gvsolgryn/Sixtar-Switch/Sixtar-Switch_PCB/image/layout.png

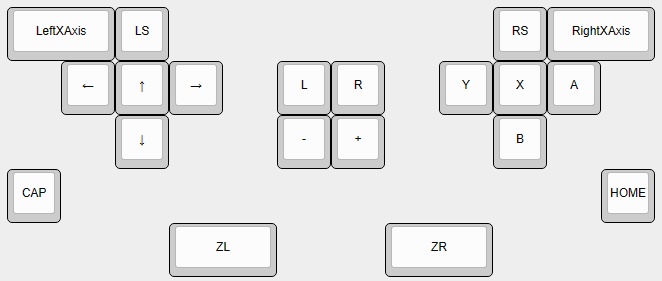
Sixtar-Switch_PCB/image/layout.png
