gvsolgryn/Sixtar-Switch/Sixtar-Switch_PCB/image/Sixtar-Switch.png

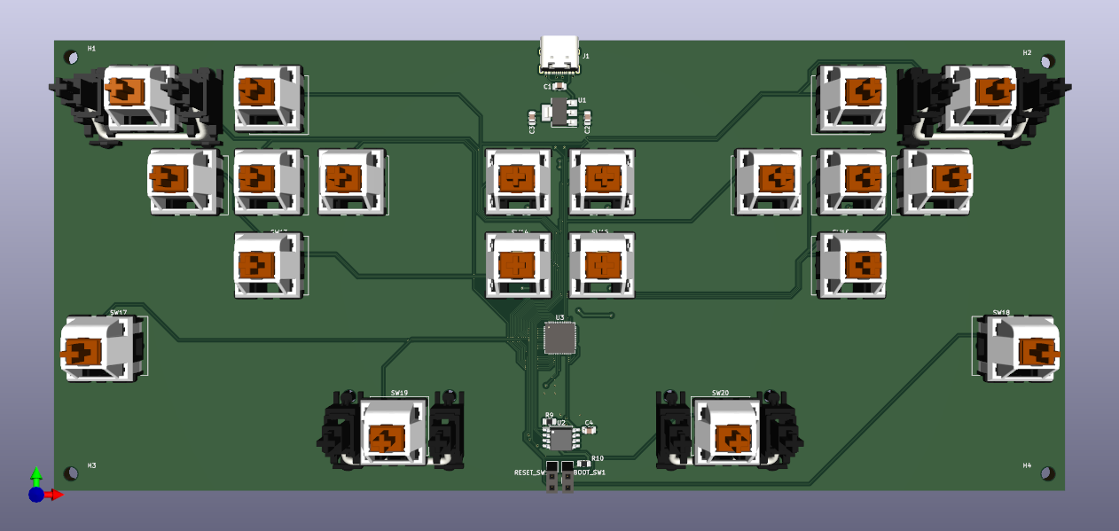
Sixtar-Switch_PCB/image/Sixtar-Switch.png
