gvsolgryn/Sixtar-Switch/Sixtar-Switch_PCB/image/Sixtar-Switch_2d.png

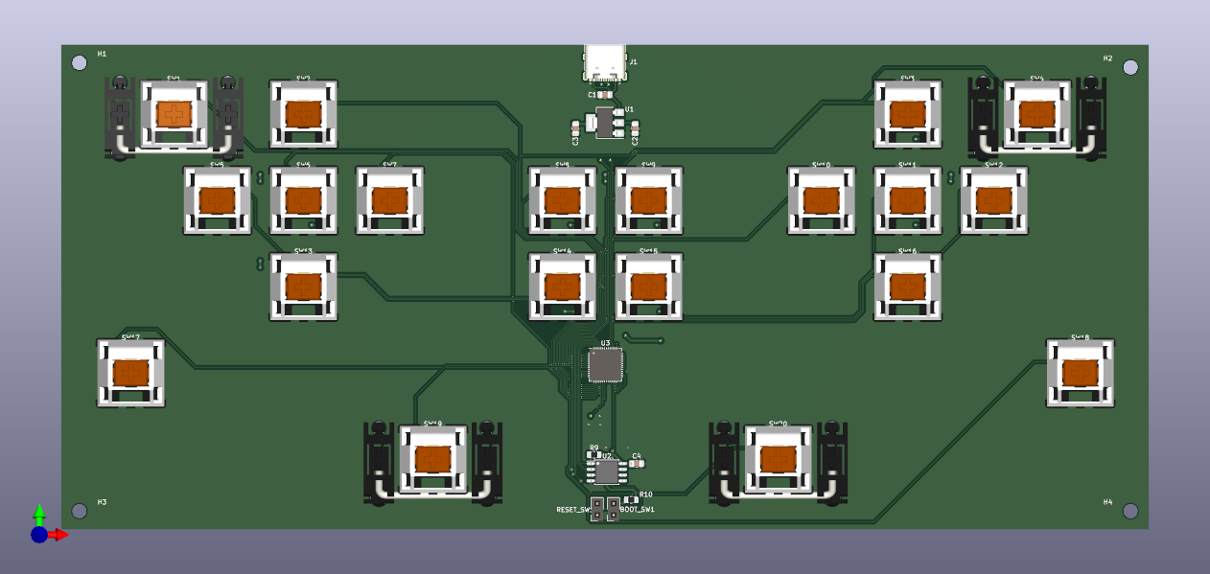
Sixtar-Switch_PCB/image/Sixtar-Switch_2d.png
