gvsolgryn/Sixtar-Switch/Sixtar-Switch_PCB/3dmodel/AMS117.stl

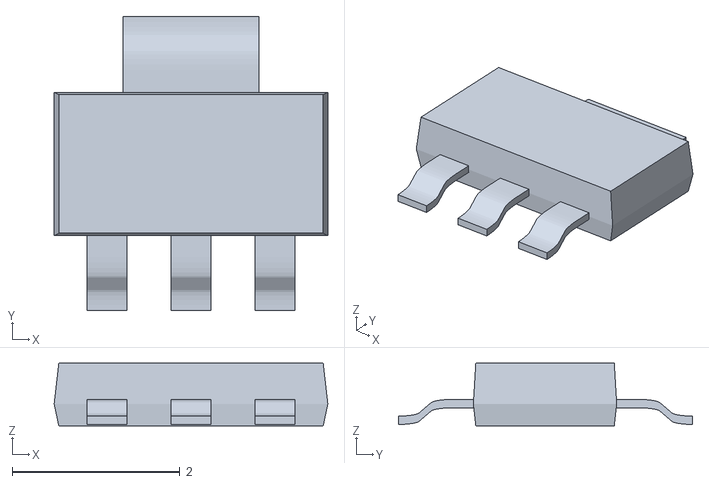
[picture p4: CAD file, 2023-10-04]
Sixtar-Switch_PCB/3dmodel/AMS117.stl
3.26 x 3.50 x 0.75
