gvsolgryn/Sixtar-Switch/Sixtar-Switch_PCB/gerber/Sixtar-Switch-PTH-drl_map.dxf

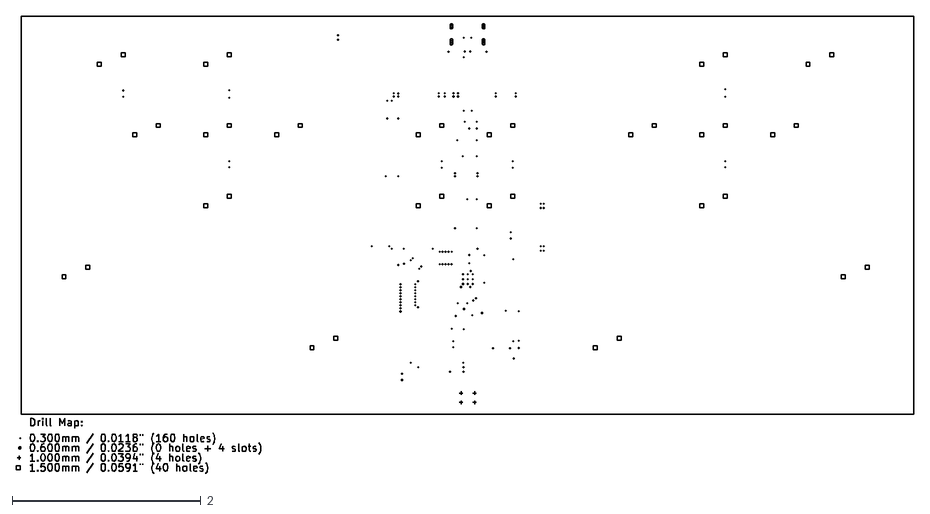
[picture p6: CAD file, 2023-10-05]
Sixtar-Switch_PCB/gerber/Sixtar-Switch-PTH-drl_map.dxf
9.50 x 4.84
