gvsolgryn/Sixtar-Switch/Sixtar-Switch_PCB/3dmodel/mx_switch/SW_Hotswap_Kailh_Choc_V1.stp

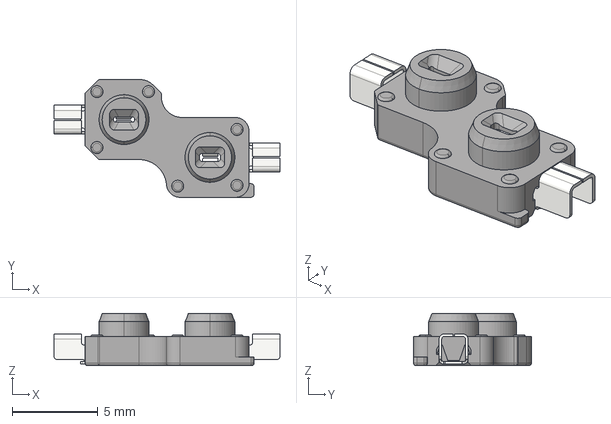
[picture p7: CAD file, 2023-10-04]
Sixtar-Switch_PCB/3dmodel/mx_switch/SW_Hotswap_Kailh_Choc_V1.stp
13.2 x 6.85 x 3.05 mm
