gvsolgryn/Sixtar-Switch/Sixtar-Switch_PCB/3dmodel/W25Q128JVSIQ.STEP

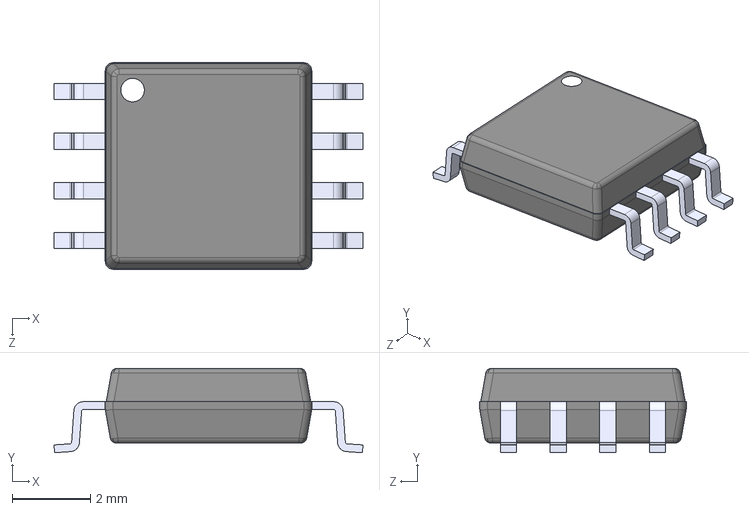
[picture p8: CAD file, 2023-10-04]
Sixtar-Switch_PCB/3dmodel/W25Q128JVSIQ.STEP
7.90 x 2.16 x 5.28 mm
