gvsolgryn/Sixtar-Switch/Sixtar-Switch_PCB/gerber/Sixtar-Switch-NPTH-drl_map.dxf

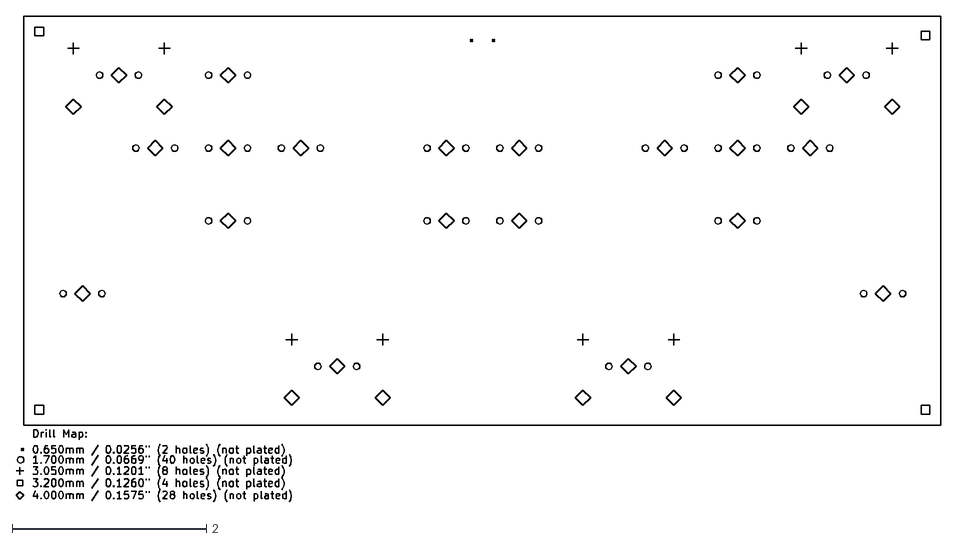
[picture p9: CAD file, 2023-10-04]
Sixtar-Switch_PCB/gerber/Sixtar-Switch-NPTH-drl_map.dxf
9.53 x 5.00
