gvsolgryn/Sixtar-Switch/Sixtar-Switch_PCB/3dmodel/mx_switch/Stabilizer_Cherry_MX_6.25u.stp

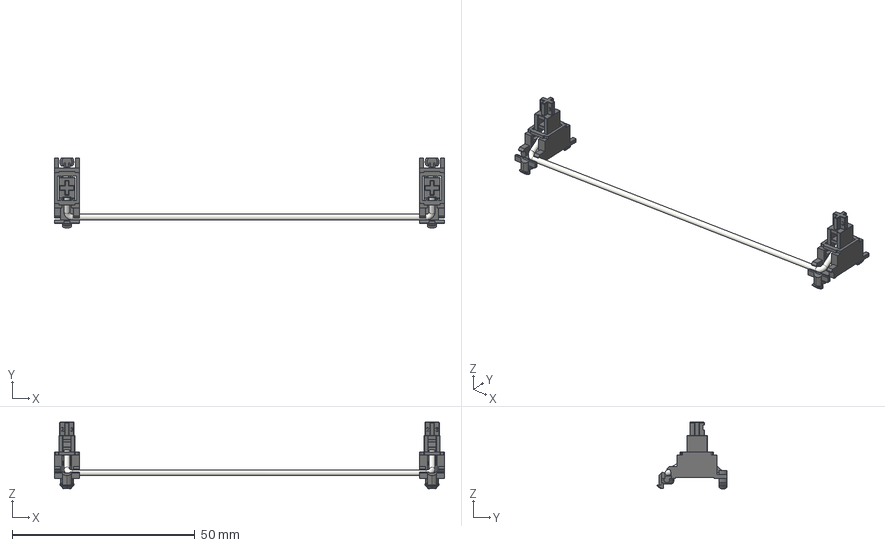
[picture p10: CAD file, 2023-10-04]
Sixtar-Switch_PCB/3dmodel/mx_switch/Stabilizer_Cherry_MX_6.25u.stp
106.8 x 19.2 x 18.3 mm
