gvsolgryn/Sixtar-Switch/Sixtar-Switch_PCB/3dmodel/u262-16xn-4bvc11.stl

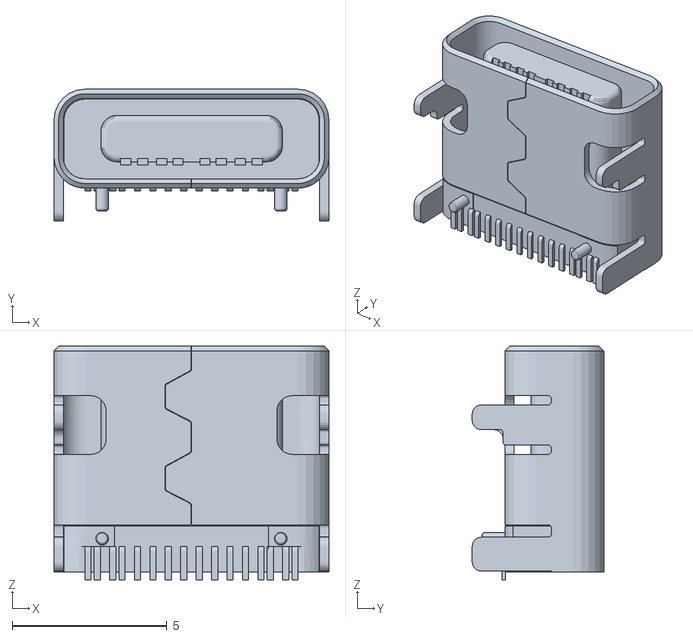
[picture p11: CAD file, 2023-10-04]
Sixtar-Switch_PCB/3dmodel/u262-16xn-4bvc11.stl
8.90 x 4.26 x 7.56
