gvsolgryn/Sixtar-Switch/Sixtar-Switch_PCB/3dmodel/mx_switch/SW_Hotswap_Kailh_MX.stp

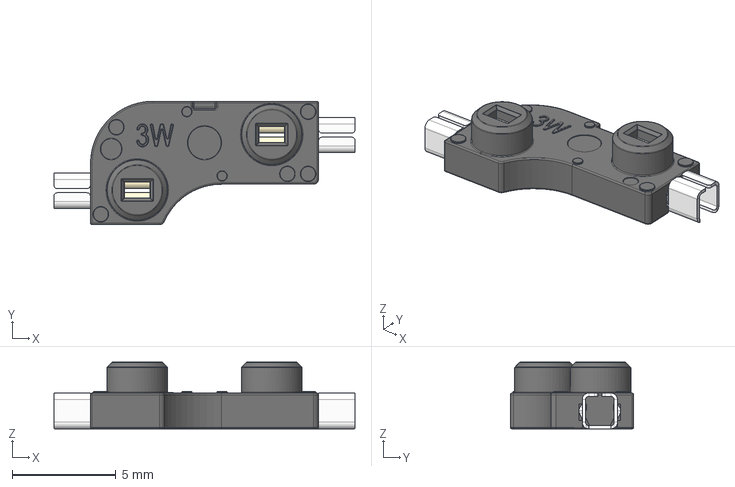
[picture p12: CAD file, 2023-10-04]
Sixtar-Switch_PCB/3dmodel/mx_switch/SW_Hotswap_Kailh_MX.stp
14.5 x 5.95 x 3.22 mm
