gvsolgryn/Sixtar-Switch/Sixtar-Switch_PCB/3dmodel/mx_switch/Stabilizer_Cherry_MX_8.00u.stp

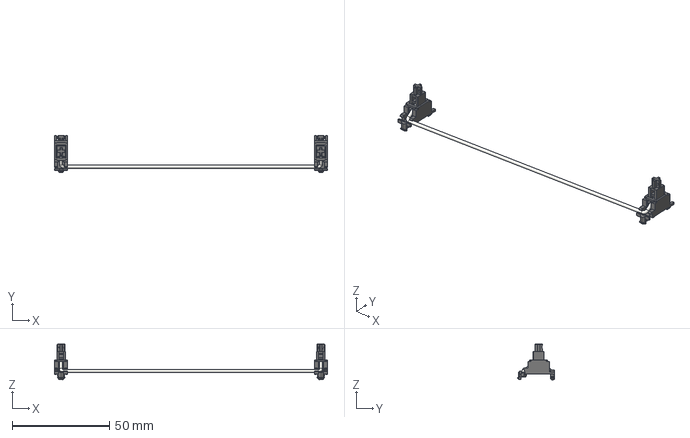
[picture p13: CAD file, 2023-10-04]
Sixtar-Switch_PCB/3dmodel/mx_switch/Stabilizer_Cherry_MX_8.00u.stp
140.1 x 19.2 x 18.3 mm
