gvsolgryn/Sixtar-Switch/Sixtar-Switch_PCB/3dmodel/mx_switch/SW_Cherry_MX_Plate.stp

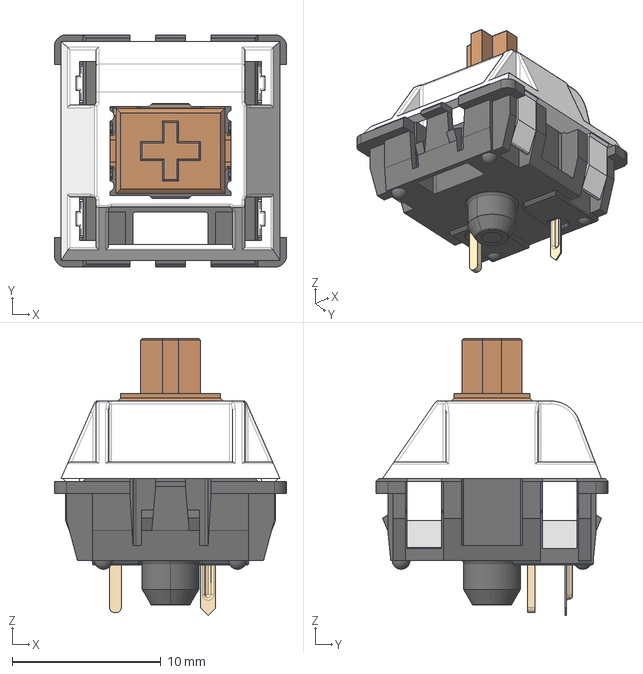
[picture p14: CAD file, 2023-10-04]
Sixtar-Switch_PCB/3dmodel/mx_switch/SW_Cherry_MX_Plate.stp
15.6 x 15.6 x 18.6 mm
