gvsolgryn/Sixtar-Switch/Sixtar-Switch_PCB/3dmodel/mx_switch/SW_Kailh_Choc_V1.stp

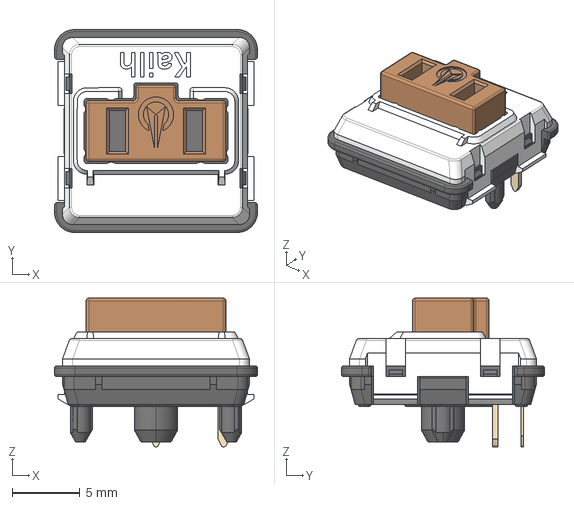
[picture p16: CAD file, 2023-10-04]
Sixtar-Switch_PCB/3dmodel/mx_switch/SW_Kailh_Choc_V1.stp
15.0 x 15.0 x 11.0 mm
