gvsolgryn/Sixtar-Switch/Sixtar-Switch_PCB/Sixtar-Switch.kicad_pcb

## KiCad design Sixtar-Switch_PCB/Sixtar-Switch.kicad_pcb (2023-10-05)

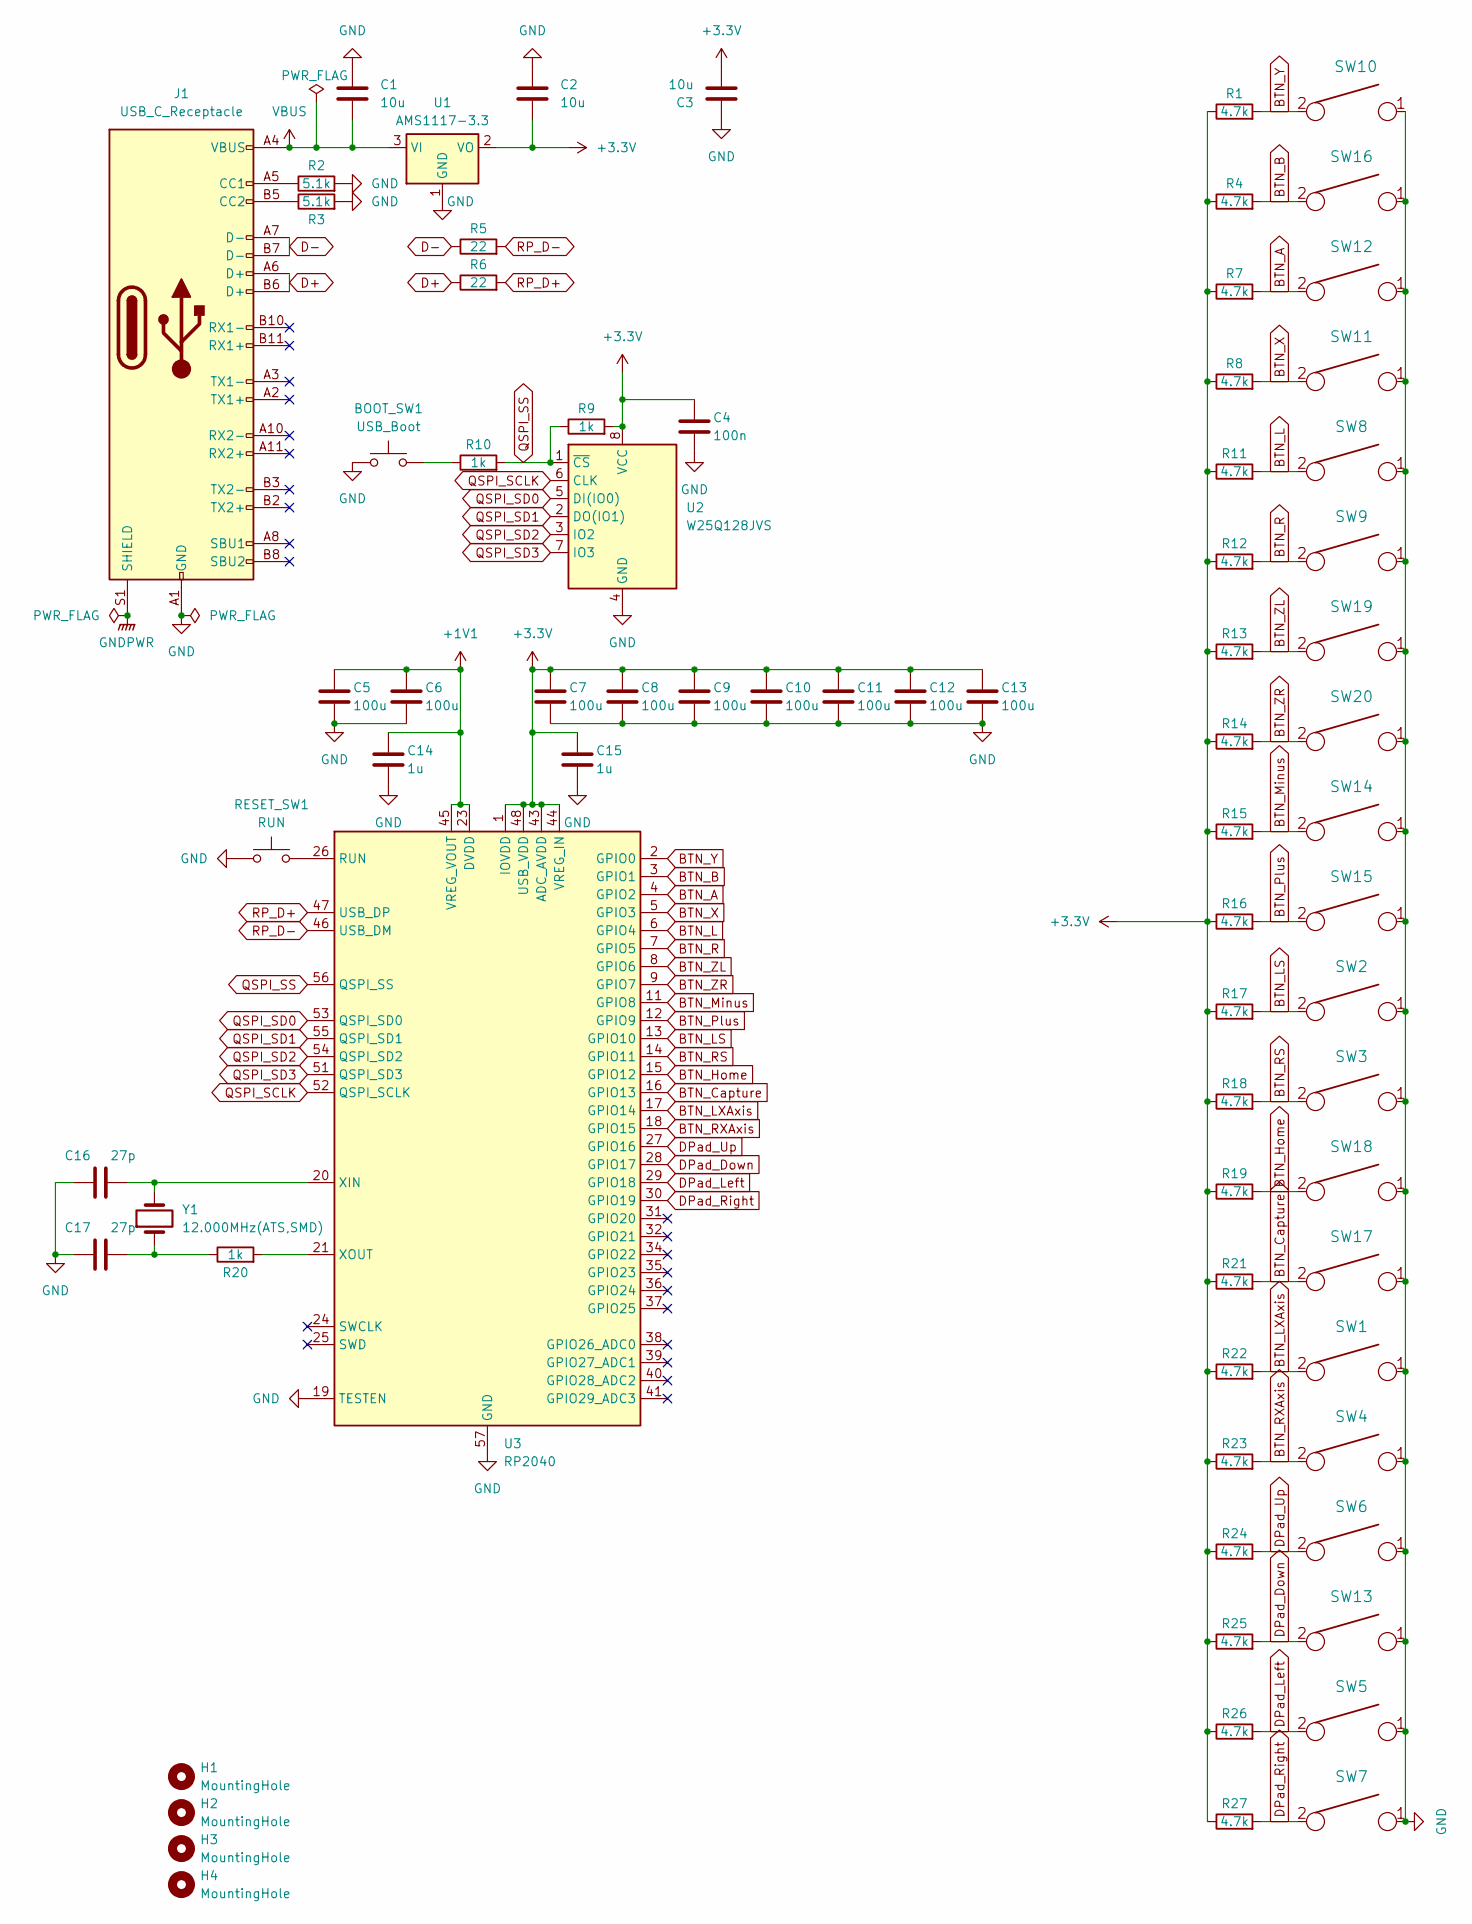
[picture p20: schematic Sixtar-Switch.kicad_sch]

Parts:
BOOT_SW1: USB_Boot; PinSocket_1x02_P2.54mm_Vertical
C1, C2, C3: 10u; C_0805_2012Metric_Pad1.18x1.45mm_HandSolder
C4: 100n; C_0805_2012Metric_Pad1.18x1.45mm_HandSolder
C5, C6, C7, C8, C9, C10, C11, C12, C13: 100u; C_0805_2012Metric_Pad1.18x1.45mm_HandSolder
C14, C15: 1u; C_0805_2012Metric_Pad1.18x1.45mm_HandSolder
C16, C17: 27p; C_0805_2012Metric_Pad1.18x1.45mm_HandSolder
H1, H2, H3, H4: MountingHole; MountingHole_3.2mm_M3
J1: USB_C_Receptacle; USB_C_Receptacle_XKB_U262-16XN-4BVC11
R1, R4, R7, R8, R11, R12, R13, R14, R15, R16, R17, R18, R19, R21, R22, R23, R24, R25, R26, R27: 4.7k; R_0805_2012Metric_Pad1.20x1.40mm_HandSolder
R2, R3: 5.1k; R_0805_2012Metric_Pad1.20x1.40mm_HandSolder
R5, R6: 22; R_0805_2012Metric_Pad1.20x1.40mm_HandSolder
R9, R10, R20: 1k; R_0805_2012Metric_Pad1.20x1.40mm_HandSolder
RESET_SW1: RUN; PinSocket_1x02_P2.54mm_Vertical
SW1, SW4, SW19, SW20: KEYSW; SW_Cherry_MX_2.00u_PCB
SW2, SW3, SW5, SW6, SW7, SW8, SW9, SW10, SW11, SW12, SW13, SW14, SW15, SW16, SW17, SW18: KEYSW; SW_Cherry_MX_1.00u_PCB
U1: AMS1117-3.3; SOT-223-3_TabPin2
U2: W25Q128JVS; SOIC-8_5.23x5.23mm_P1.27mm
U3: RP2040; QFN-56-1EP_7x7mm_P0.4mm_EP3.2x3.2mm
Y1: 12.000MHz(ATS,SMD); Crystal_SMD_5032-2Pin_5.0x3.2mm

Connections:
+1V1: C5.1, C6.1, C14.1, U3.23 (DVDD), U3.45 (VREG_VOUT), U3.50 (DVDD)
+3.3V: C2.2, C3.2, C4.1, C7.1, C8.1, C9.1, C10.1, C11.1, C12.1, C13.1, C15.1, R1.1, R4.1, R7.1, R8.1, R9.2, R11.1, R12.1, R13.1, R14.1, R15.1, R16.1, R17.1, R18.1, R19.1, R21.1, R22.1, R23.1, R24.1, R25.1, R26.1, R27.1, U1.2 (VO), U2.8 (VCC), U3.1 (IOVDD), U3.10 (IOVDD), U3.22 (IOVDD), U3.33 (IOVDD), U3.42 (IOVDD), U3.43 (ADC_AVDD), U3.44 (VREG_IN), U3.48 (USB_VDD), U3.49 (IOVDD)
BTN_A: R7.2, SW12.2, U3.4 (GPIO2)
BTN_B: R4.2, SW16.2, U3.3 (GPIO1)
BTN_Capture: R21.2, SW17.2, U3.16 (GPIO13)
BTN_Home: R19.2, SW18.2, U3.15 (GPIO12)
BTN_L: R11.2, SW8.2, U3.6 (GPIO4)
BTN_LS: R17.2, SW2.2, U3.13 (GPIO10)
BTN_LXAxis: R22.2, SW1.2, U3.17 (GPIO14)
BTN_Minus: R15.2, SW14.2, U3.11 (GPIO8)
BTN_Plus: R16.2, SW15.2, U3.12 (GPIO9)
BTN_R: R12.2, SW9.2, U3.7 (GPIO5)
BTN_RS: R18.2, SW3.2, U3.14 (GPIO11)
BTN_RXAxis: R23.2, SW4.2, U3.18 (GPIO15)
BTN_X: R8.2, SW11.2, U3.5 (GPIO3)
BTN_Y: R1.2, SW10.2, U3.2 (GPIO0)
BTN_ZL: R13.2, SW19.2, U3.8 (GPIO6)
BTN_ZR: R14.2, SW20.2, U3.9 (GPIO7)
D+: J1.A6 (D+), J1.B6 (D+), R6.1
D-: J1.A7 (D-), J1.B7 (D-), R5.1
DPad_Down: R25.2, SW13.2, U3.28 (GPIO17)
DPad_Left: R26.2, SW5.2, U3.29 (GPIO18)
DPad_Right: R27.2, SW7.2, U3.30 (GPIO19)
DPad_Up: R24.2, SW6.2, U3.27 (GPIO16)
GND: BOOT_SW1.1, C1.1, C2.1, C3.1, C4.2, C5.2, C6.2, C7.2, C8.2, C9.2, C10.2, C11.2, C12.2, C13.2, C14.2, C15.2, C16.1, C17.1, J1.A1 (GND), J1.A12 (GND), J1.B1 (GND), J1.B12 (GND), R2.2, R3.2, RESET_SW1.1, SW1.1, SW2.1, SW3.1, SW4.1, SW5.1, SW6.1, SW7.1, SW8.1, SW9.1, SW10.1, SW11.1, SW12.1, SW13.1, SW14.1, SW15.1, SW16.1, SW17.1, SW18.1, SW19.1, SW20.1, U1.1 (GND), U2.4 (GND), U3.19 (TESTEN), U3.57 (GND)
GNDPWR: J1.S1 (SHIELD)
unnamed: BOOT_SW1.2, R10.1
unnamed: C17.2, R20.1, Y1.1
unnamed: J1.A5 (CC1), R2.1
unnamed: J1.B5 (CC2), R3.1
unnamed: RESET_SW1.2, U3.26 (RUN)
unnamed: C16.2, U3.20 (XIN), Y1.2
unnamed: R20.2, U3.21 (XOUT)
QSPI_SCLK: U2.6 (CLK), U3.52 (QSPI_SCLK)
QSPI_SD0: U2.5 (DI(IO0)), U3.53 (QSPI_SD0)
QSPI_SD1: U2.2 (DO(IO1)), U3.55 (QSPI_SD1)
QSPI_SD2: U2.3 (IO2), U3.54 (QSPI_SD2)
QSPI_SD3: U2.7 (IO3), U3.51 (QSPI_SD3)
QSPI_SS: R9.1, R10.2, U2.1 (~CS), U3.56 (QSPI_SS)
RP_D+: R6.2, U3.47 (USB_DP)
RP_D-: R5.2, U3.46 (USB_DM)
VBUS: C1.2, J1.A4 (VBUS), J1.A9 (VBUS), J1.B4 (VBUS), J1.B9 (VBUS), U1.3 (VI)

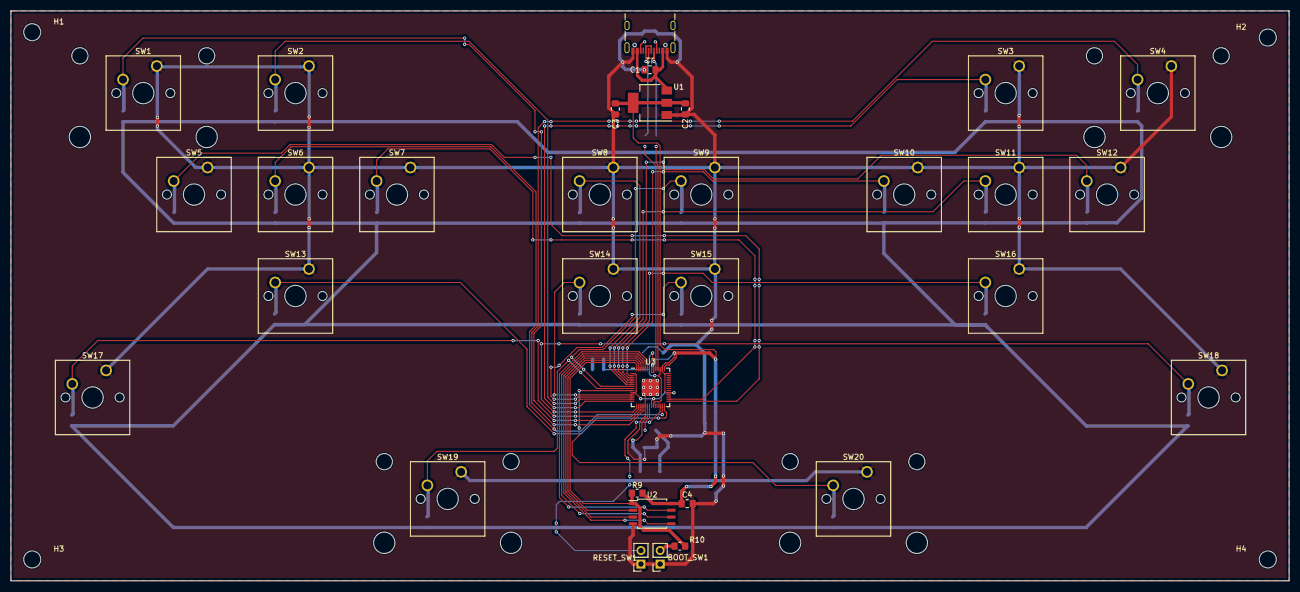
[picture p21: board Sixtar-Switch.kicad_pcb from above]

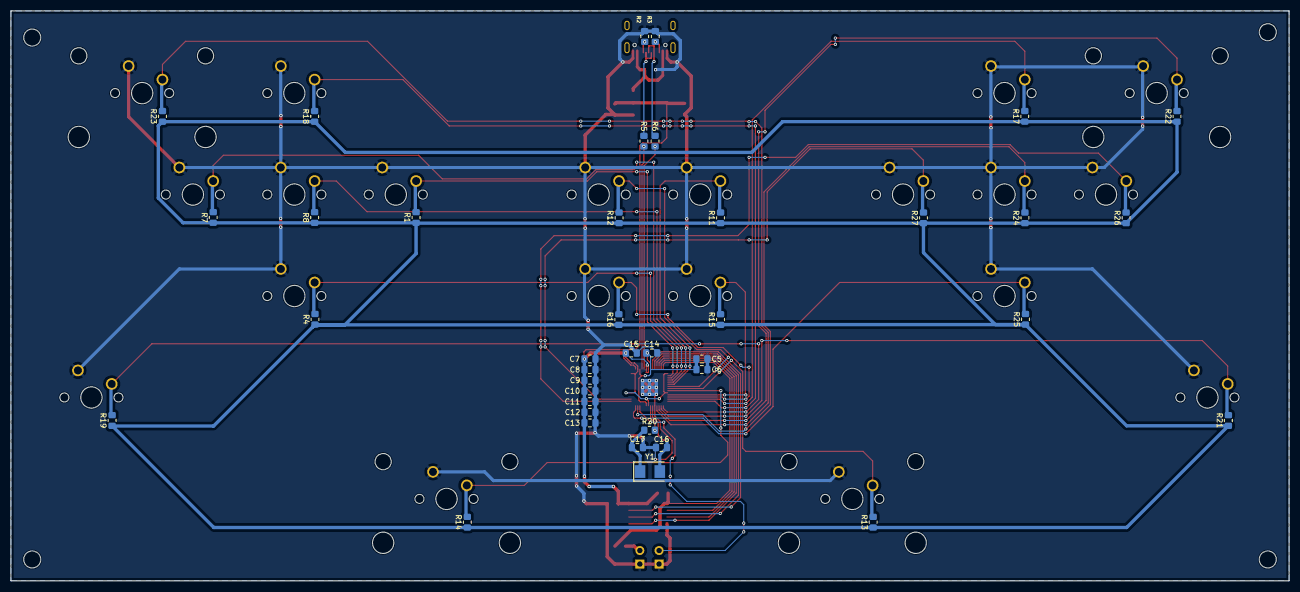
[picture p22: board Sixtar-Switch.kicad_pcb from below]

Board: 2 copper layers, 240.0 x 107.0 mm, 75 parts (39 on the bottom side), 41 nets.
