gvsolgryn/Sixtar-Switch/(commit log)

2023-04-03 KiCad Project init
    [Sixtar-Switch.kicad_pcb, Sixtar-Switch.kicad_sch]
2023-04-03 Add new Directory for PCB
    [Sixtar-Switch.kicad_pcb, Sixtar-Switch.kicad_sch]
2023-04-03 Init Arduino Workspace
2023-05-09 RPi-Pico SDK Submodule 설정
2023-05-10 gitsubmodule 제거
2023-05-10 펌웨어 코드 위치 변경
2023-05-10 includepath 변경(진행중)
2023-05-10 SwitchControlLibrary 추가(포팅필요)
2023-05-10 폴더 이름 변경 및 폴더 위치 변경
2023-05-10 tiniusb 지원을 위해 코드 추가
2023-05-10 .gitignore 추가
2023-05-10 vscode setting 수정
2023-05-10 tinyusb 빌드를 위해 수정
2023-05-10 pico-example 코드로 변경
2023-05-10 GamePad 기초 테스트 코드로 수정
2023-05-10 VID PID 수정 및 GamePad 로만 인식하도록 수정
2023-05-11 .vscode 폴더 업로드 안하도록 .gitignore 수정
2023-05-11 gitignore 수정 및 git 캐시삭제
2023-05-12 GamePad HID 전송 안되던 오류 수정
2023-05-12 코드 수정중
2023-05-15 코드 위치 변경 (src -> src/include)
2023-05-15 코드 위치 변경에 따른 CMakeLists 변경
2023-05-15 포팅 or 참조용 코드 위치 변경
2023-05-15 불필요한 코드 삭제
2023-05-15 switchControllLibrary 참조하여 헤더 추가
2023-05-15 테스트용 코드 수정 - boot 버튼 누를 시 Hat UP 하도록 수정
2023-05-16 rp2040 HID Gamepad 기초 코드 작성
2023-05-16 들여쓰기 4 -> 공백 4 로 변경
2023-05-16 nintendo switch joystick report (테스트 필요)
2023-05-16 버그 수정중 - HID 인식 안됨 - 포팅을 다시 진행해야함
2023-05-18 닌텐도 스위치용 HID 디스크립터 변경
2023-05-18 스위치 작동 확인 하지만 버그 발견 - 엔디안 오류가 있는 것 같음
2023-09-18 gitignore 수정
2023-09-18 소스코드 테스트중...
2023-09-19 디렉터리 정리
2023-09-19 Raspberry Pi Pico C/C++ SDK 이용 스위치 컨트롤러 코드 수정 완료 - GPIO0 ~ GPIO13에 버튼값들 할당 완료 - HAT 및 다른 기능들 추가 해야함
    [main.cpp, main.h]
2023-09-19 닌텐도 스위치의 모든 버튼 및 axis 작동 확인 - GPIO0 ~ 13 = 스위치 버튼 Y, B, A, X, L트리거, R트리거, ZL트리거, ZR트리거, 마이너스, 플러스, L스틱, R스틱, 홈, 캡쳐 - GPIO14 = L스틱 왼쪽방향으로 틀기 - GPIO15 = R스틱 오른쪽방향으로 틀기
    [Sixtar-Switch.kicad_sch]
2023-09-19 닌텐도 스위치의 dPad 버튼 작동 확인 - GPIO15 ~ 18 = up, down, left, right 로 매핑
2023-09-19 pin 중복 할당 수정
    [main.h]
2023-09-19 kicad 회로 수정
    [Sixtar-Switch.kicad_sch]
2023-09-25 KiCAD 회로 수정 및 PCB 제작중
    [Sixtar-Switch.kicad_pcb, Sixtar-Switch.kicad_sch]
2023-09-25 키 배치 수정
    [Sixtar-Switch.kicad_pcb, Sixtar-Switch.kicad_sch]
2023-09-25 저항 배치중
    [Sixtar-Switch.kicad_pcb]
2023-09-26 저항 배치 및 배선 그리는중
    [Sixtar-Switch.kicad_pcb]
2023-10-04 PCB빌드 완료. 테스트 필요
    [Sixtar-Switch-B_Adhesive.gbr, Sixtar-Switch-B_Courtyard.gbr, Sixtar-Switch-B_Cu.gbr, Sixtar-Switch-B_Fab.gbr, Sixtar-Switch-B_Mask.gbr, Sixtar-Switch-B_Paste.gbr, Sixtar-Switch-B_Silkscreen.gbr, Sixtar-Switch-Edge_Cuts.gbr]
2023-10-04 3d 모델 완성
    [AMS117.stl, SW_Cherry_MX_PCB.stp, SW_Cherry_MX_Plate.stp, SW_Hotswap_Kailh_Choc_V1.stp, SW_Hotswap_Kailh_MX.stp, SW_Kailh_Choc_V1.stp, Sixtar-Switch.kicad_pcb, Stabilizer_Cherry_MX_2.00u.stp]
2023-10-04 이미지 추가
2023-10-05 PCB via hole 잘못되서 처음부터 다시 라인 작업해야함
    [Sixtar-Switch.kicad_pcb]
2023-10-05 배선 수정 및 via hole 수정
    [Sixtar-Switch-B_Adhesive.gbr, Sixtar-Switch-B_Courtyard.gbr, Sixtar-Switch-B_Cu.gbr, Sixtar-Switch-B_Fab.gbr, Sixtar-Switch-B_Mask.gbr, Sixtar-Switch-B_Paste.gbr, Sixtar-Switch-B_Silkscreen.gbr, Sixtar-Switch-Edge_Cuts.gbr]
